ObsidianFury1/ultrasonic-landing-prediction/code/pipeline/web_assets/session_report.html

Session -- Per-throw report

No valid prediction

Landing scope · polar from centroid

Predicted landing

Raw trilateration

range r

bearing θ

x

z

Raw Bias-corrected

Ground truth · centroid + 2-sensor survey

Recommended references: centroid + -- — the two sensors nearest the predicted landing.

centroid S1 S2 S3

Accept recommended L → centroid

m

L → --

m

L → --

m

Compute & save → next

The recommendation only chooses which tapes are easiest to measure accurately; the landing is solved from the three measured distances, so accepting it does not bias the result.

Surveyed vs predicted

2-D Euclidean error · raw prediction

truth r

truth θ

truth x

truth z

Saved to session.json → ground_truth. Page is now frozen and self-contained.

Trajectory · vertical profile (downrange × height)

raw Kalman parabola fit

2D 3D

Range vs time · per-sensor gate behaviour

accepted gated throw window

Triplets used · in-window

Heading φ · speed v_h

Temp · sound m/s

Fit dof (N − 3)

Malformed lines

Small-sample caveat
