ObsidianFury1/ultrasonic-landing-prediction/optical/calib/targets/aruco_markers.pdf

DICT_4X4_50 ID 0 (100 x 100 mm)
Optical.md sect 3.3 -- floor marker.

H scale bar: measure this line, must be 100 mm V scale bar: 100 mm

DICT_4X4_50 ID 1 (100 x 100 mm)
Optical.md sect 3.3 -- floor marker.

H scale bar: measure this line, must be 100 mm V scale bar: 100 mm

DICT_4X4_50 ID 2 (100 x 100 mm)
Optical.md sect 3.3 -- floor marker.

H scale bar: measure this line, must be 100 mm V scale bar: 100 mm

DICT_4X4_50 ID 3 (100 x 100 mm)
Optical.md sect 3.3 -- floor marker.

H scale bar: measure this line, must be 100 mm V scale bar: 100 mm

DICT_4X4_50 ID 4 (100 x 100 mm)
Optical.md sect 3.3 -- floor marker.

H scale bar: measure this line, must be 100 mm V scale bar: 100 mm

DICT_4X4_50 ID 5 (100 x 100 mm)
Optical.md sect 3.3 -- floor marker.

H scale bar: measure this line, must be 100 mm V scale bar: 100 mm

DICT_4X4_50 ID 6 (100 x 100 mm)
Optical.md sect 3.3 -- floor marker.

H scale bar: measure this line, must be 100 mm V scale bar: 100 mm

DICT_4X4_50 ID 7 (100 x 100 mm)
Optical.md sect 3.3 -- floor marker.

H scale bar: measure this line, must be 100 mm V scale bar: 100 mm
