ObsidianFury1/ultrasonic-landing-prediction/optical/calib/targets/checkerboard_9x6.pdf

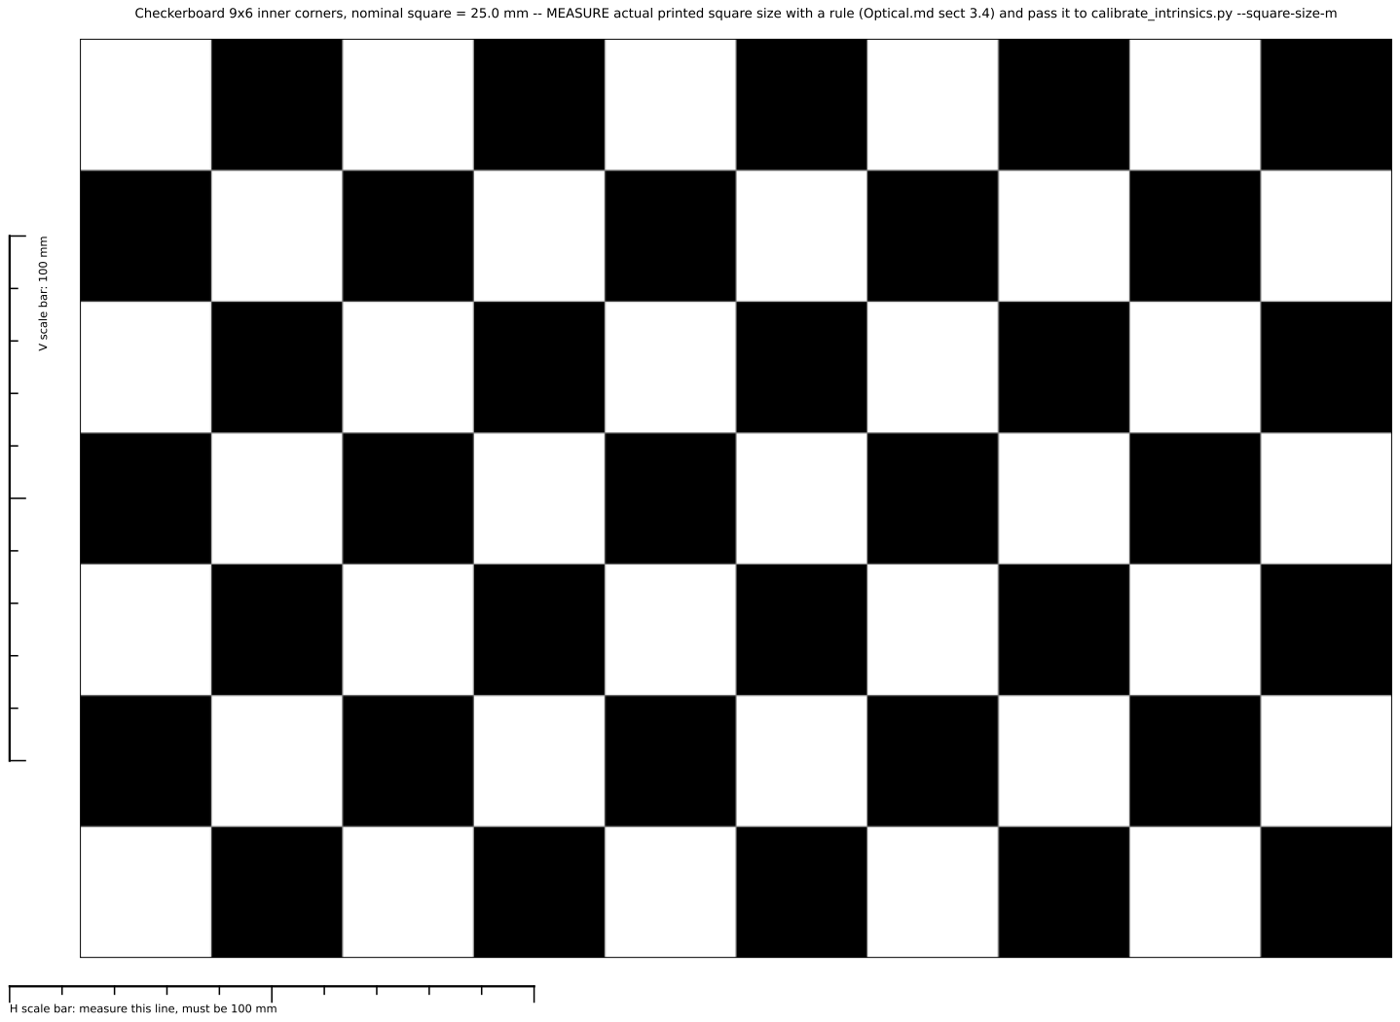
[picture p11: page 1]

Checkerboard 9x6 inner corners, nominal square = 25.0 mm -- MEASURE actual printed square size with a rule (Optical.md sect 3.4) and pass it to calibrate_intrinsics.py --square-size-m

# H scale bar: measure this line, must be 100 mm V scale bar: 100 mm
