ObsidianFury1/ultrasonic-landing-prediction/optical/trilateration_log.csv

timestamp | label | ref1_name | ref1_dist_m | ref2_name | ref2_dist_m | ref3_name | ref3_dist_m | x_m | z_m | r_m | theta_deg | ls_residual_m | cond_number | cond_warn
2026-07-11T16:20:29 | ID_2 | centroid | 0.25 | S1 | 0.7 | S2 | 0.34 | -0.0809 | 0.2345 | 0.2481 | 109.03 | 0.0021 | 1.73 | FALSE
2026-07-11T16:21:32 | ID_0 | centroid | 0.56 | S2 | 0.6 | S3 | 0.53 | -0.5563 | -0.0398 | 0.5577 | -175.91 | 0.00237 | 1.73 | FALSE
2026-07-11T16:22:06 | ID_3 | centroid | 0.52 | S1 | 0.53 | S3 | 0.58 | 0.2848 | -0.4382 | 0.5226 | -56.98 | 0.00297 | 1.73 | FALSE
2026-07-11T16:22:50 | ID_1 | centroid | 0.735 | S1 | 0.69 | S2 | 0.63 | 0.3288 | 0.6495 | 0.7279 | 63.15 | 0.00598 | 1.73 | FALSE
2026-07-11T16:24:47 | ID_4 | centroid | 1.56 | S1 | 1.68 | S3 | 1.1 | -0.0268 | -1.5651 | 1.5653 | -90.98 | 0.00382 | 1.73 | FALSE
2026-07-11T16:25:19 | ID_7 | centroid | 1.38 | S2 | 1.23 | S3 | 1.17 | -1.3778 | -0.072 | 1.3797 | -177.01 | 0.00023 | 1.73 | FALSE
2026-07-11T16:47:17 | Camera | centroid | 3 | S1 | 3.15 | S3 | 2.44 | -0.5892 | -2.9297 | 2.9884 | -101.37 | 0.00846 | 1.73 | FALSE
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
