ObsidianFury1/ultrasonic-landing-prediction/code/campaign_report/error_vs_heading.png

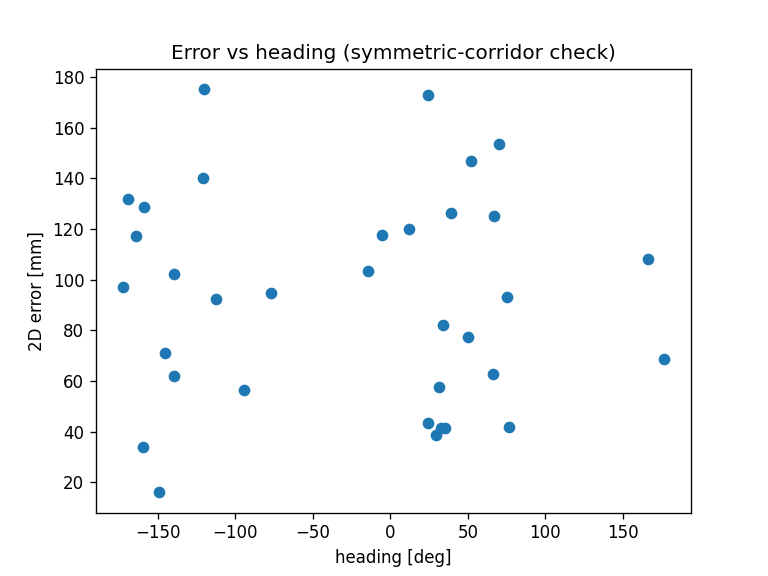
code/campaign_report/error_vs_heading.png
