ObsidianFury1/ultrasonic-landing-prediction/code/campaign_report/triplets_hist.png

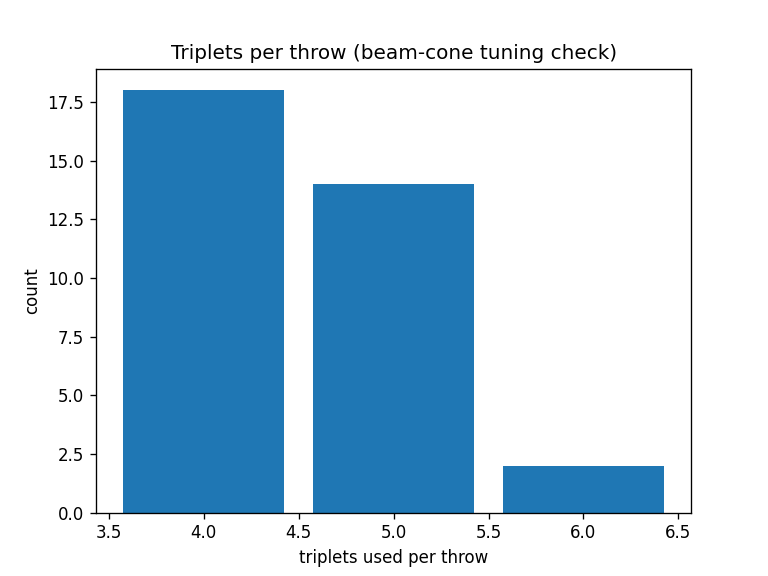
code/campaign_report/triplets_hist.png
