ObsidianFury1/ultrasonic-landing-prediction/code/data/sessions/2026-07-09_T35/plots/trajectory_fit.png

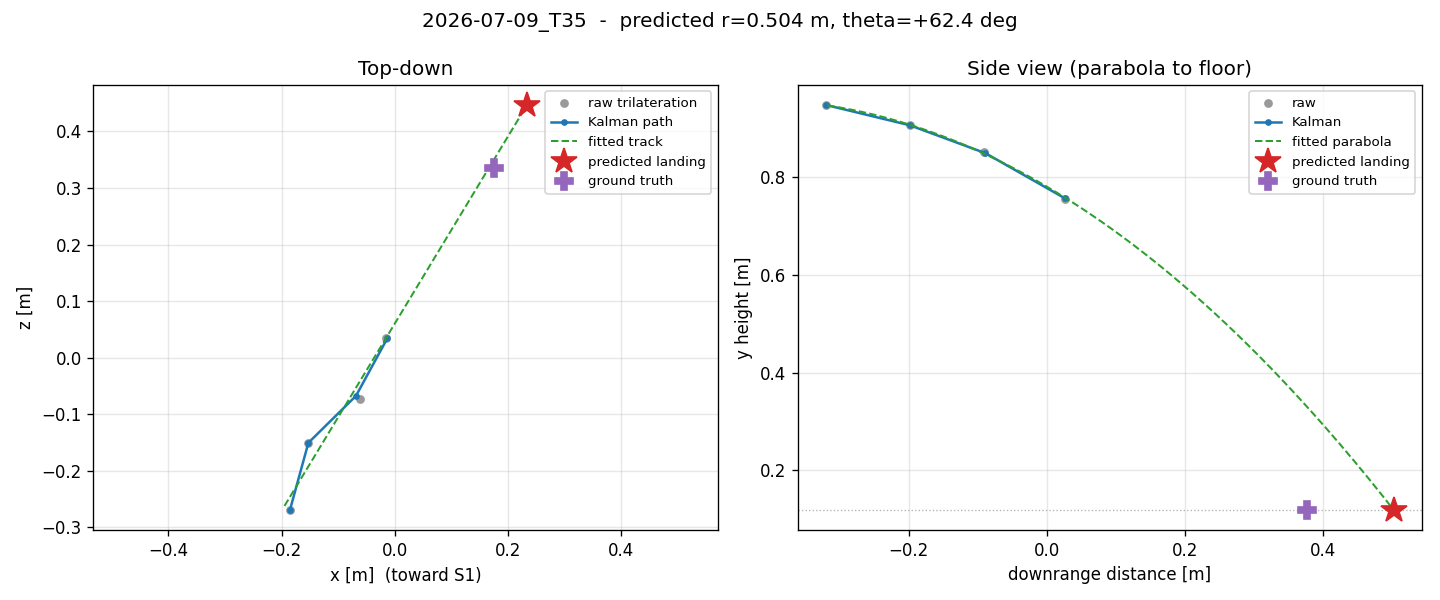
code/data/sessions/2026-07-09_T35/plots/trajectory_fit.png
