ObsidianFury1/ultrasonic-landing-prediction/code/data/sessions/2026-07-09_T54/plots/range_vs_time.png

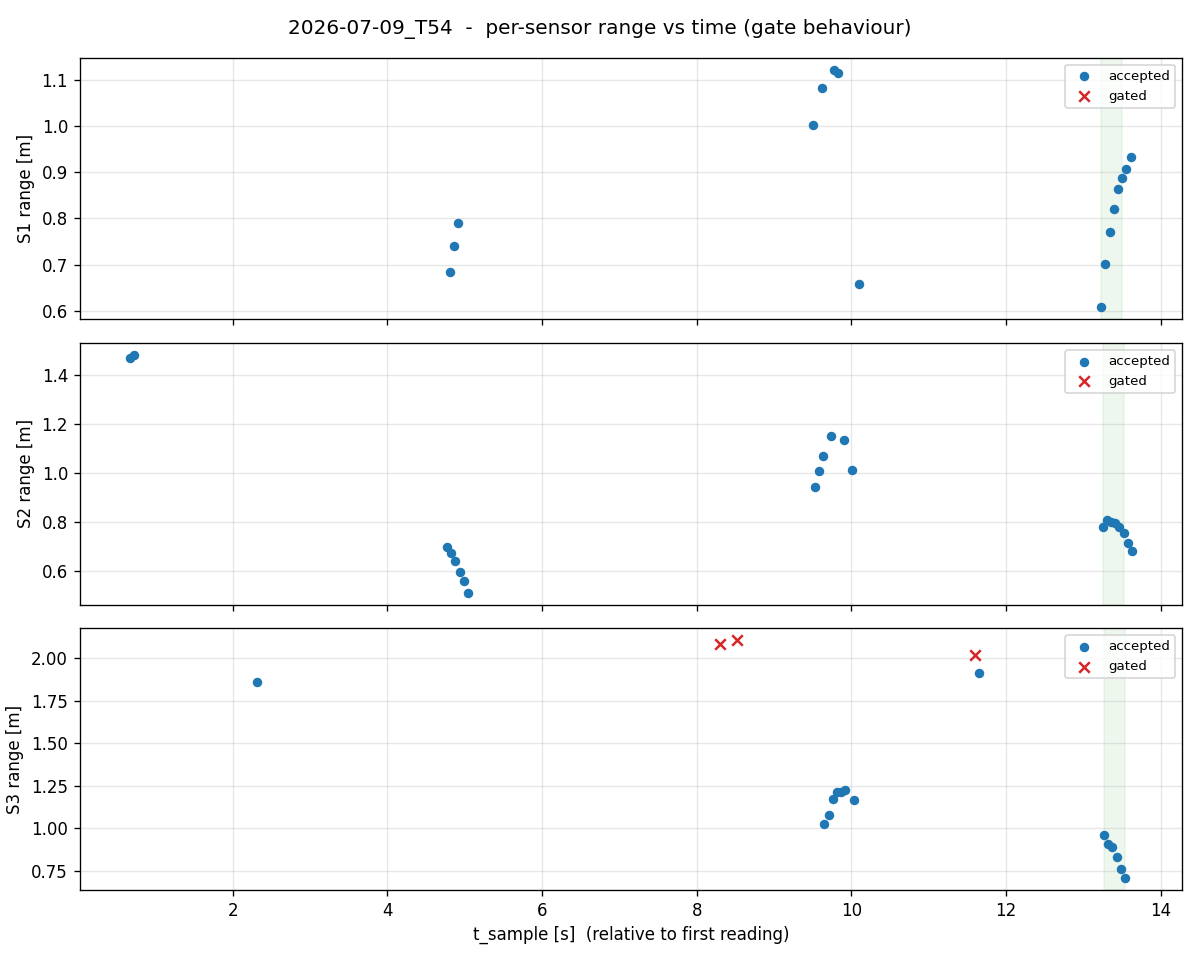
code/data/sessions/2026-07-09_T54/plots/range_vs_time.png
