ObsidianFury1/ultrasonic-landing-prediction/code/data/sessions/demo/sim_2026-07-09_010625_S06/plots/range_vs_time.png

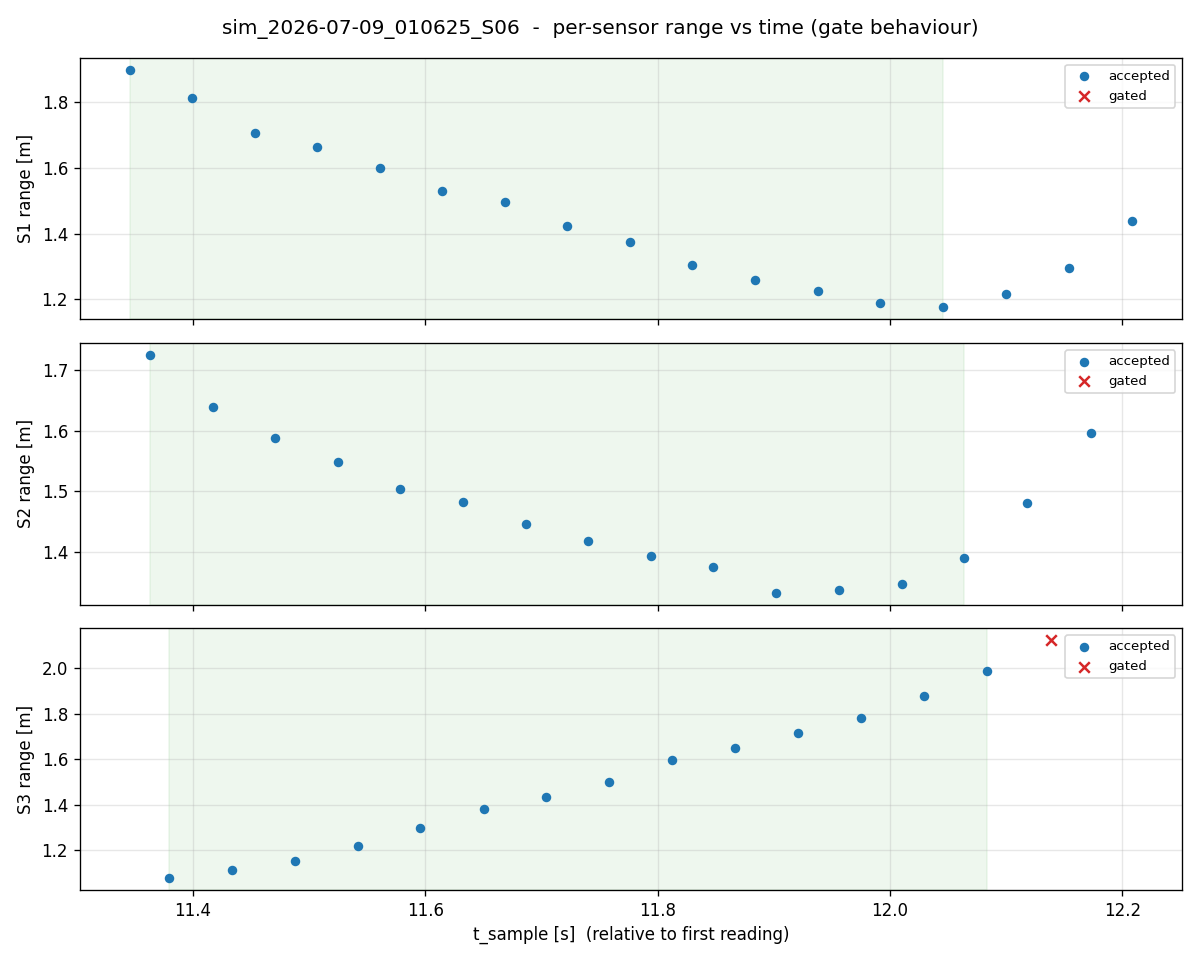
code/data/sessions/demo/sim_2026-07-09_010625_S06/plots/range_vs_time.png
