ObsidianFury1/ultrasonic-landing-prediction/code/data/sessions/demo/sim_2026-07-09_010625_S07/plots/trajectory_true.png

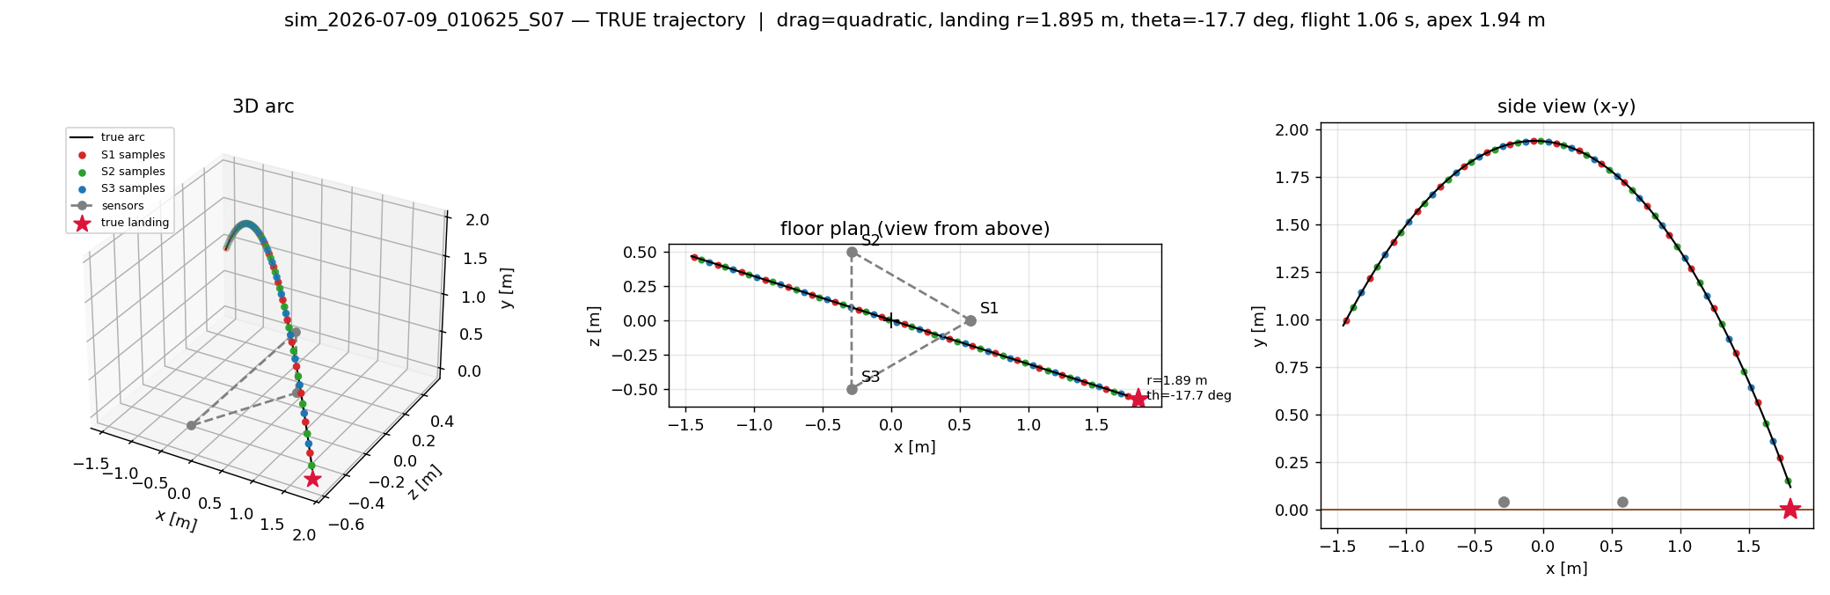
code/data/sessions/demo/sim_2026-07-09_010625_S07/plots/trajectory_true.png
