ObsidianFury1/ultrasonic-landing-prediction/code/data/sessions/demo/sim_2026-07-09_010625_S09/plots/trajectory_fit.png

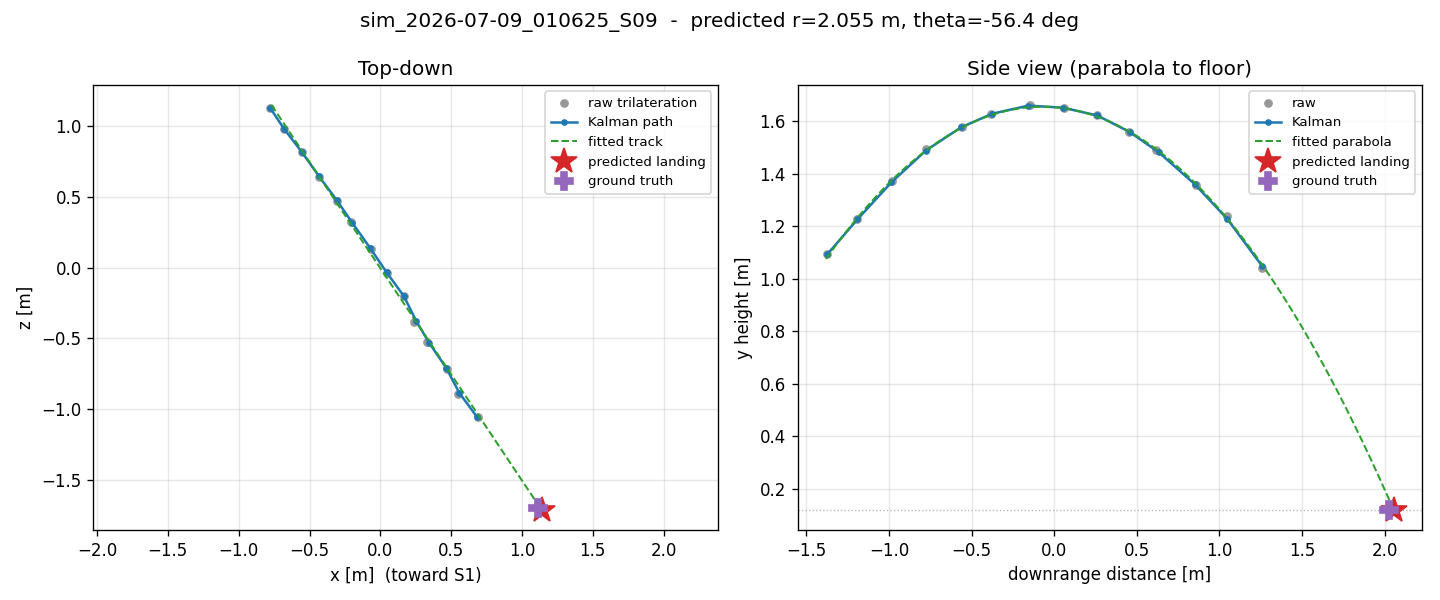
code/data/sessions/demo/sim_2026-07-09_010625_S09/plots/trajectory_fit.png
