ObsidianFury1/ultrasonic-landing-prediction/code/report/figures/array_geometry.png

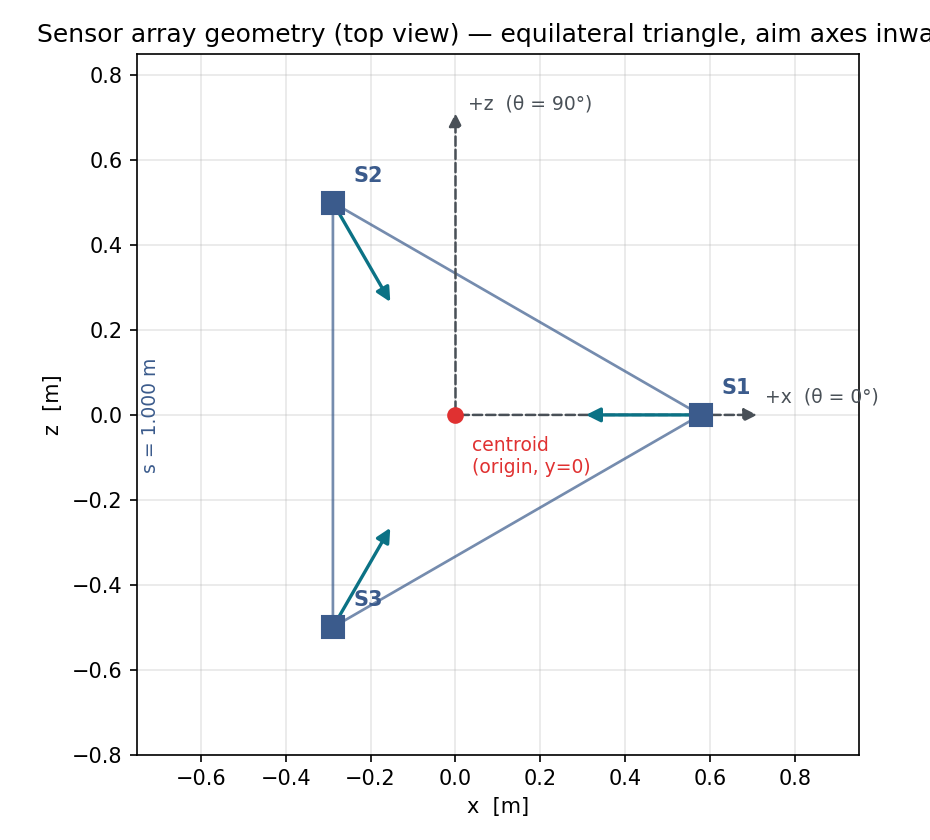
code/report/figures/array_geometry.png
