ObsidianFury1/ultrasonic-landing-prediction/docs/presentation-figures/slide03_hardware_geometry.png

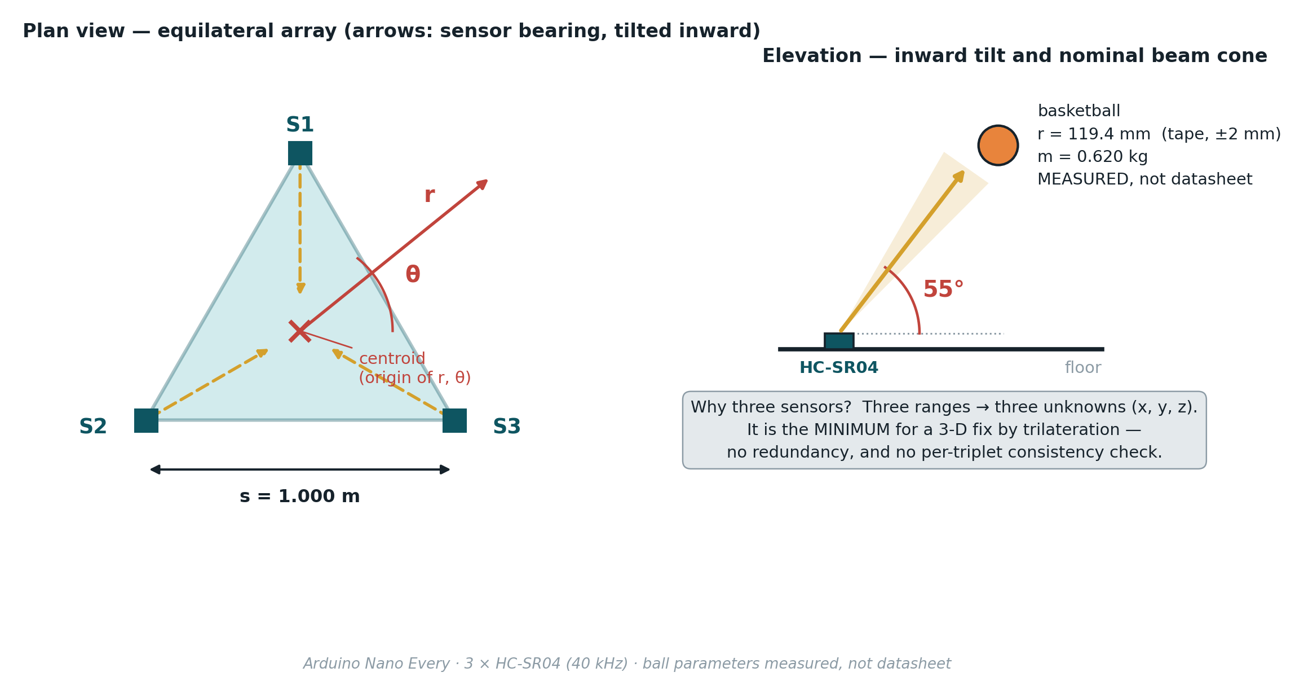
docs/presentation-figures/slide03_hardware_geometry.png
