ObsidianFury1/ultrasonic-landing-prediction/docs/presentation-figures/slide04_timing_diagram.png

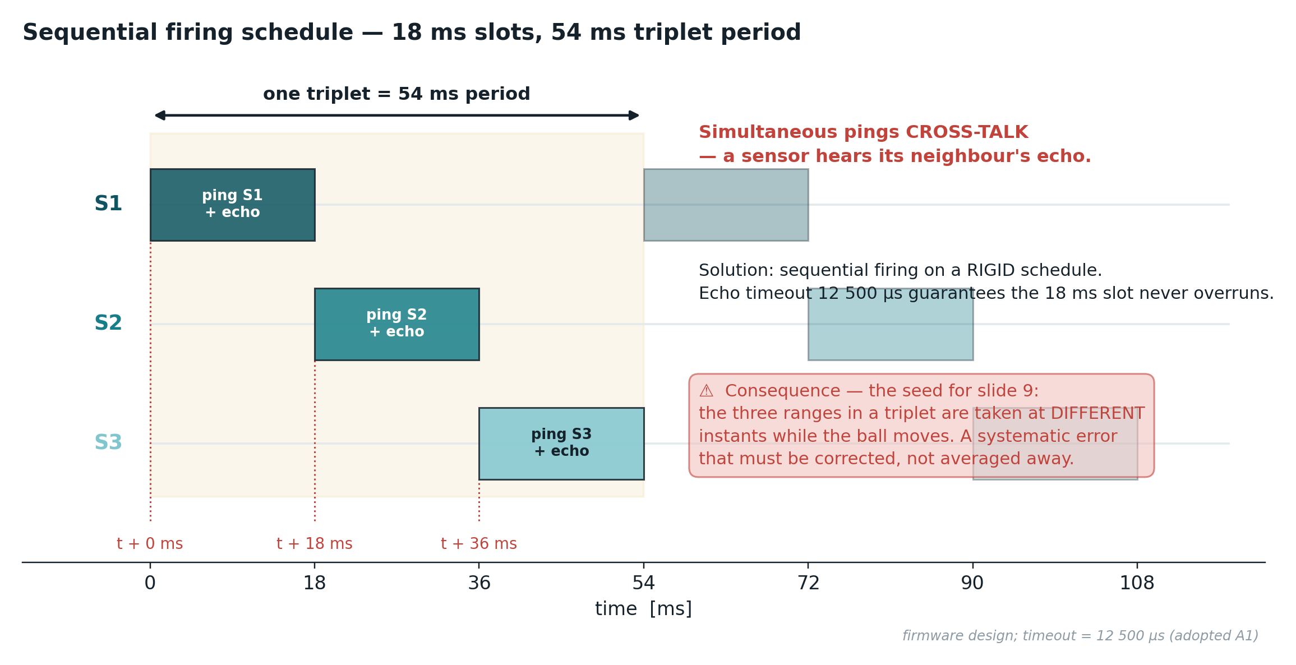
docs/presentation-figures/slide04_timing_diagram.png
