ObsidianFury1/ultrasonic-landing-prediction/docs/presentation-figures/slide07_error_budget.png

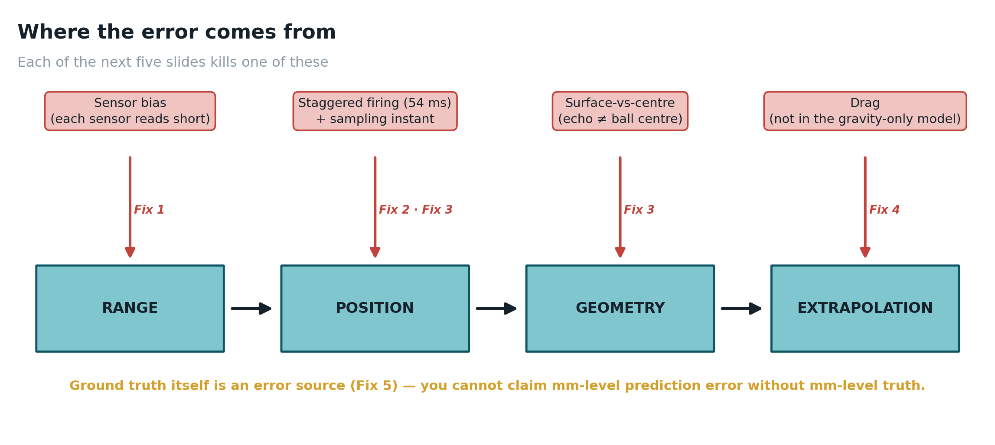
docs/presentation-figures/slide07_error_budget.png
