ObsidianFury1/ultrasonic-landing-prediction/docs/presentation-figures/slide14_campaign.png

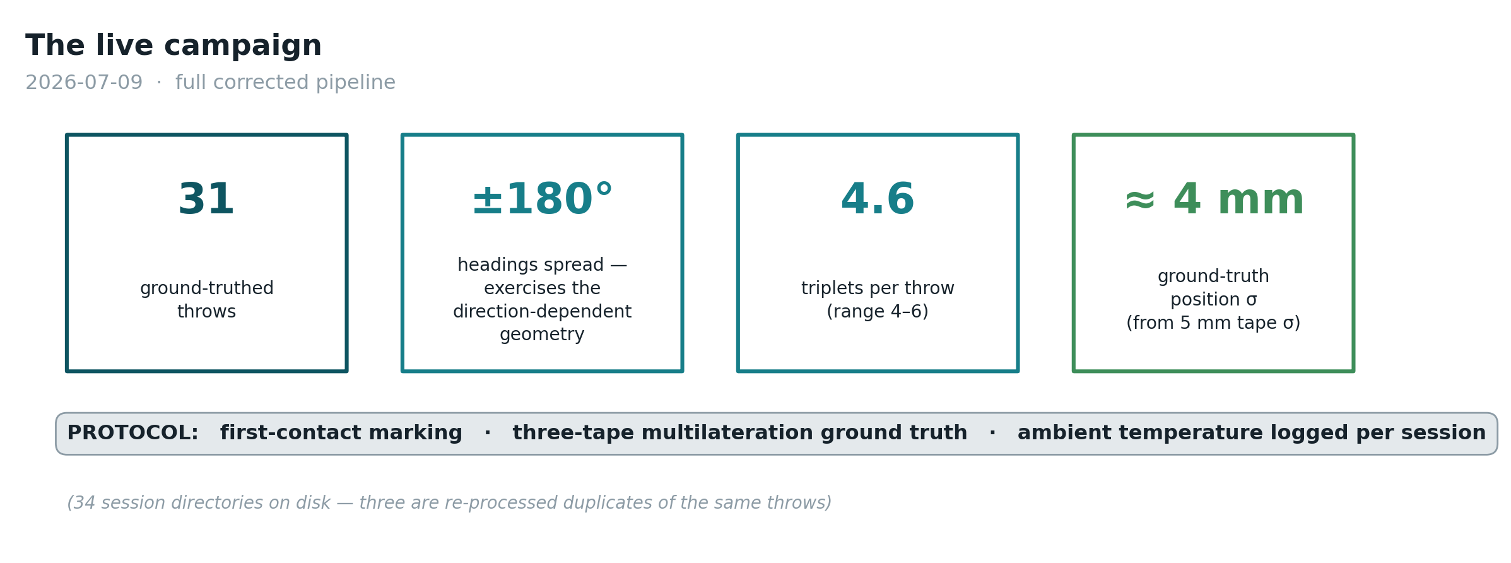
docs/presentation-figures/slide14_campaign.png
