ObsidianFury1/ultrasonic-landing-prediction/docs/presentation-figures/slide16_uncertainty_ellipse.png

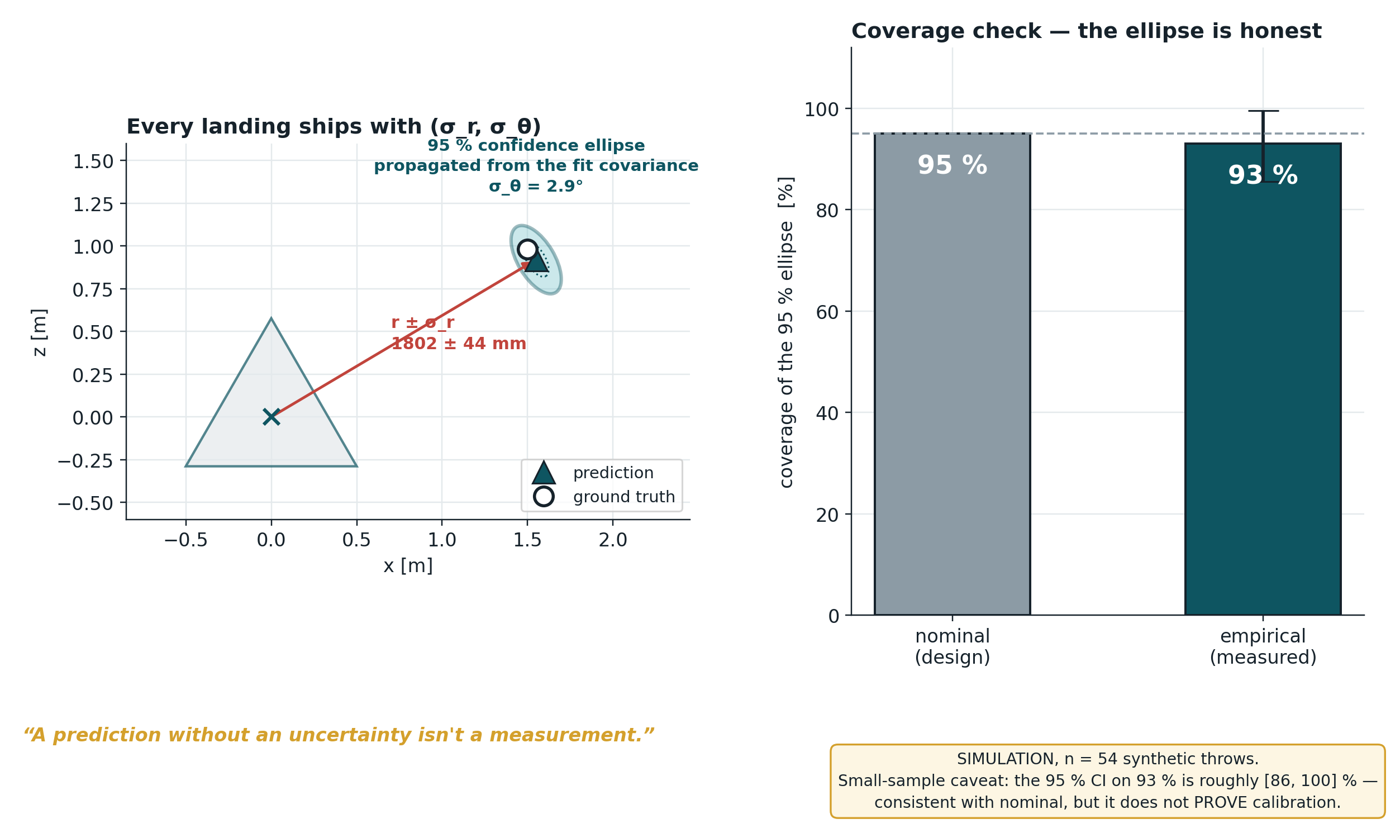
docs/presentation-figures/slide16_uncertainty_ellipse.png
