ObsidianFury1/ultrasonic-landing-prediction/docs/presentation-figures/slide17_conclusions_sensor.png

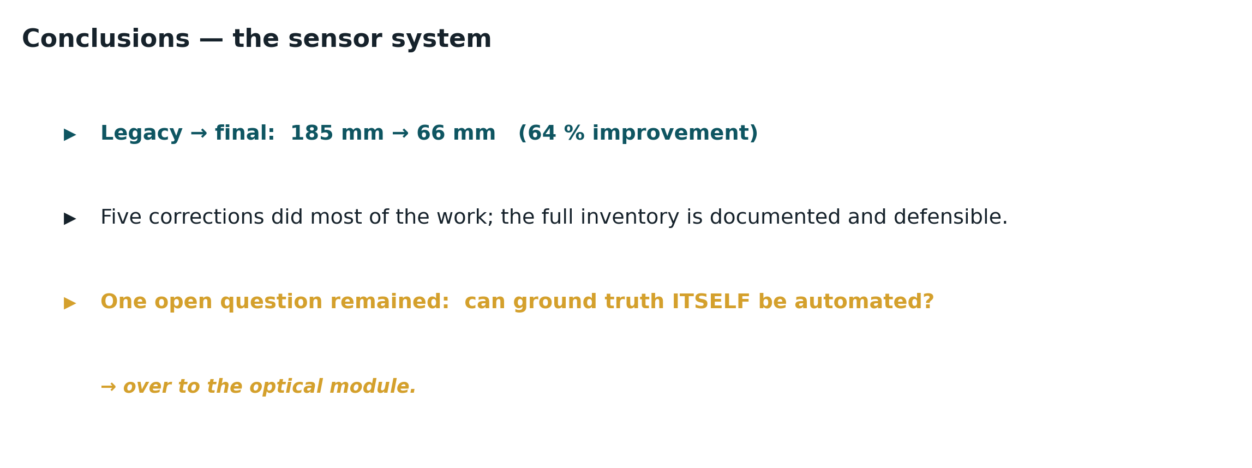
docs/presentation-figures/slide17_conclusions_sensor.png
