ObsidianFury1/ultrasonic-landing-prediction/docs/presentation-figures/slide17_waterfall_thumbnail.png

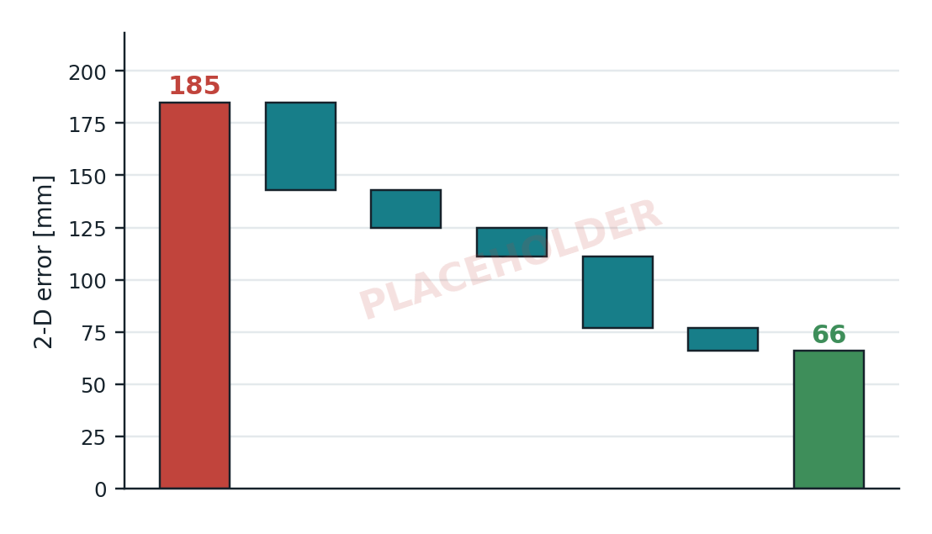
docs/presentation-figures/slide17_waterfall_thumbnail.png
