ObsidianFury1/ultrasonic-landing-prediction/docs/presentation-figures/slide19_optical_method.png

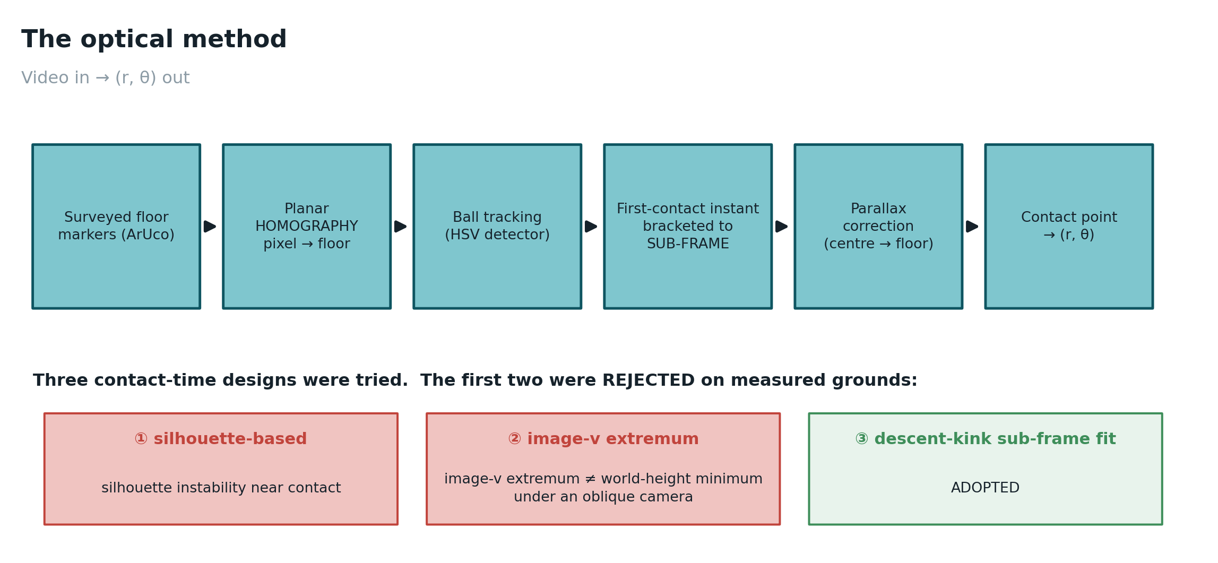
docs/presentation-figures/slide19_optical_method.png
