ObsidianFury1/ultrasonic-landing-prediction/docs/presentation-figures/slide20_pre_registered_gate.png

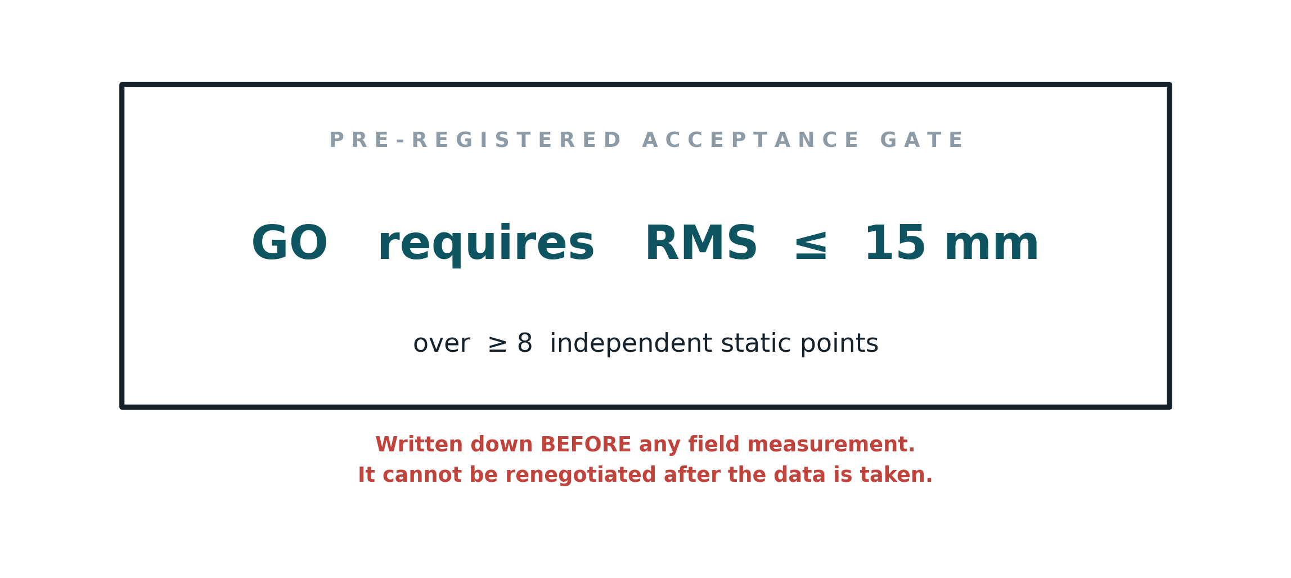
docs/presentation-figures/slide20_pre_registered_gate.png
