ObsidianFury1/ultrasonic-landing-prediction/docs/presentation-figures/slide21_optical_nogo.png

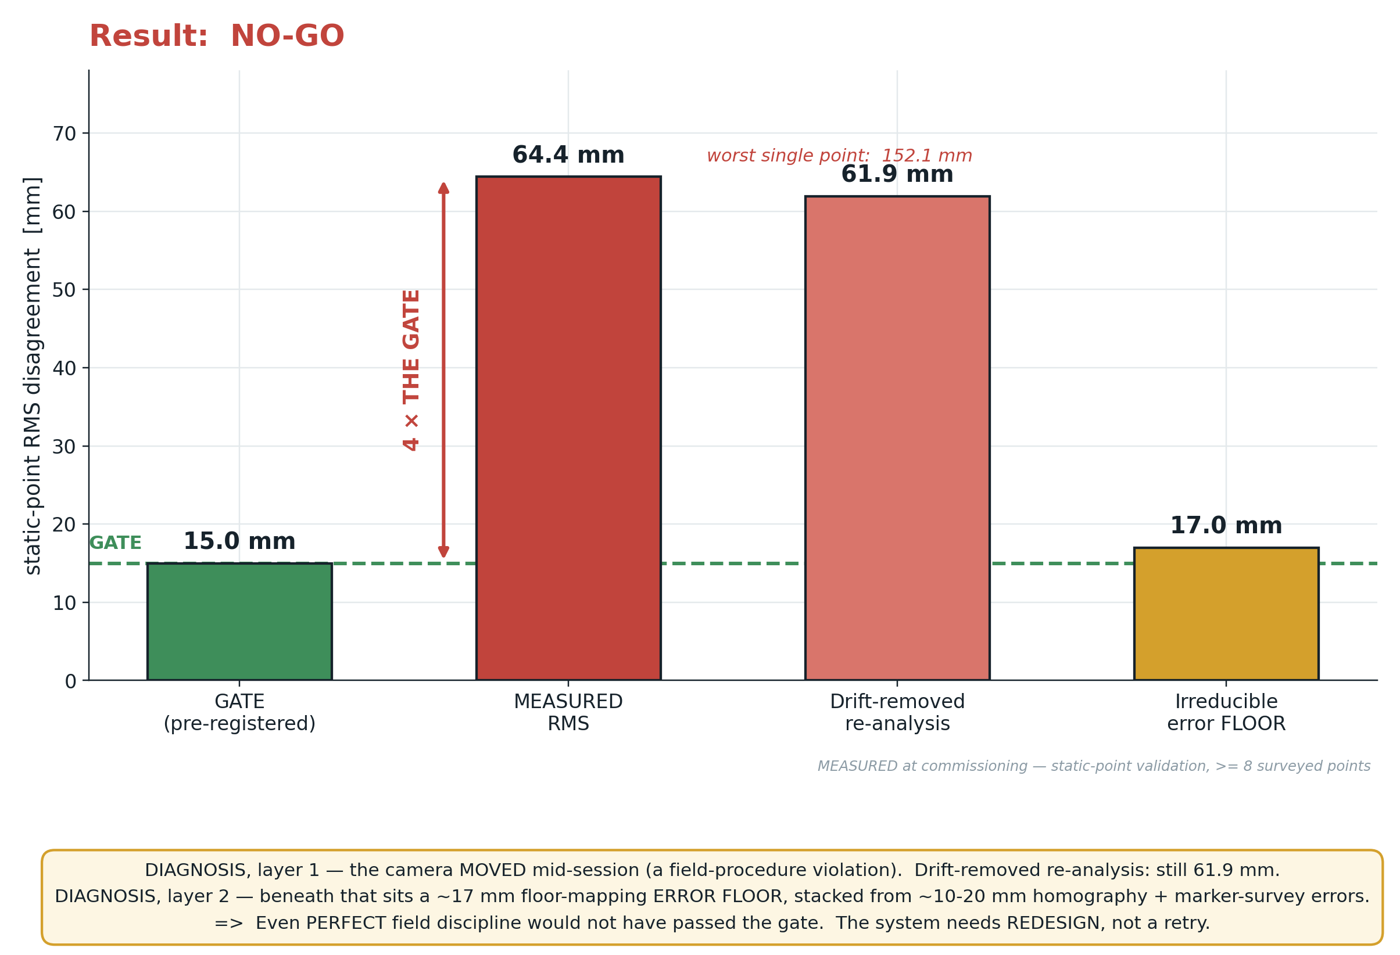
docs/presentation-figures/slide21_optical_nogo.png
