ObsidianFury1/ultrasonic-landing-prediction/docs/presentation-figures/slide22_verdict.png

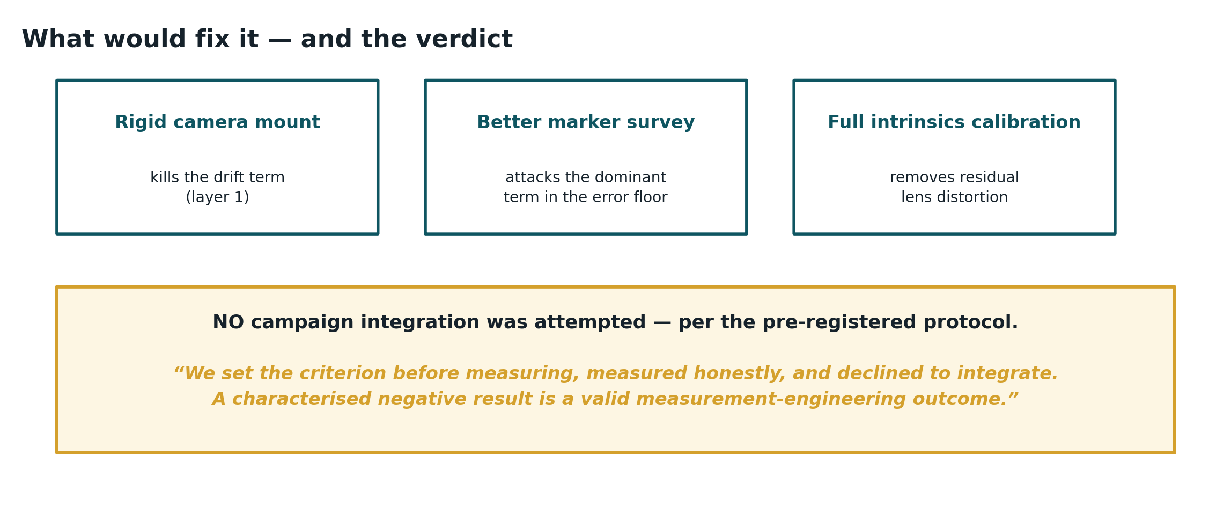
docs/presentation-figures/slide22_verdict.png
