ObsidianFury1/ultrasonic-landing-prediction/optical/calib/targets/aruco_marker_0.jpg

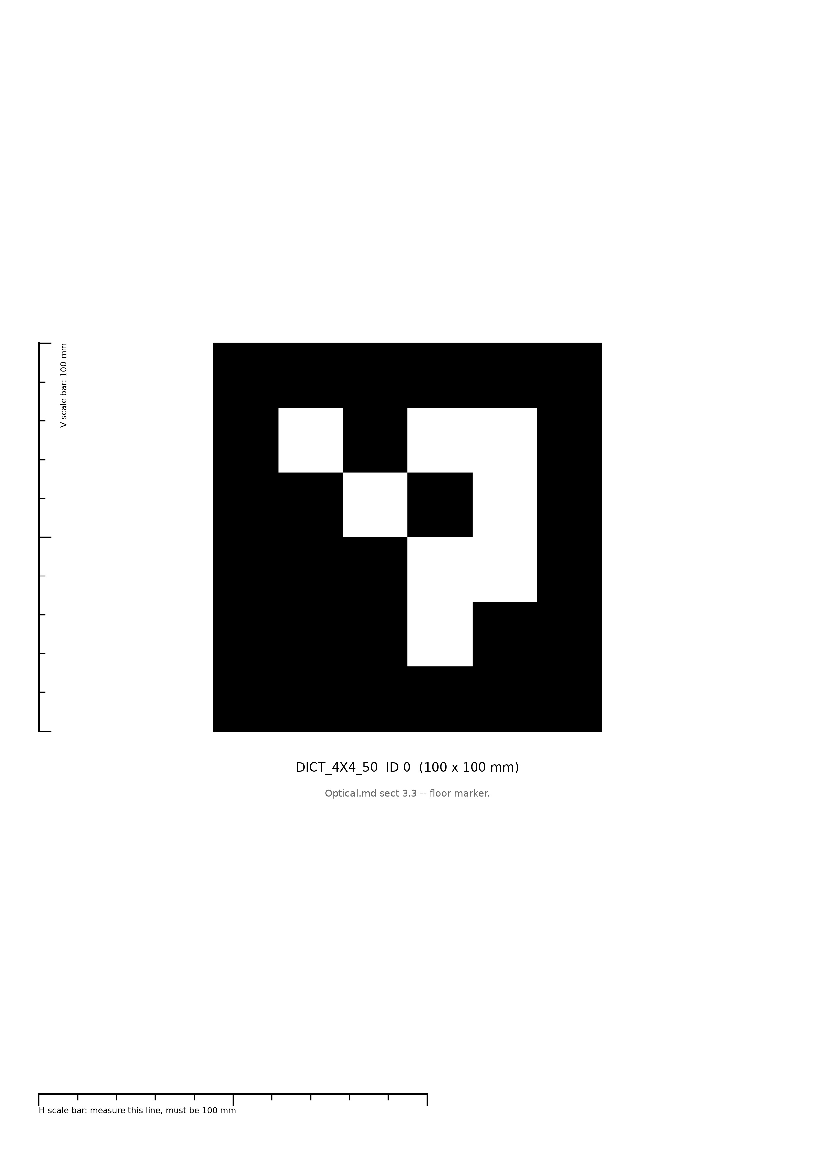
optical/calib/targets/aruco_marker_0.jpg
