ObsidianFury1/ultrasonic-landing-prediction/optical/calib/targets/aruco_marker_6.jpg

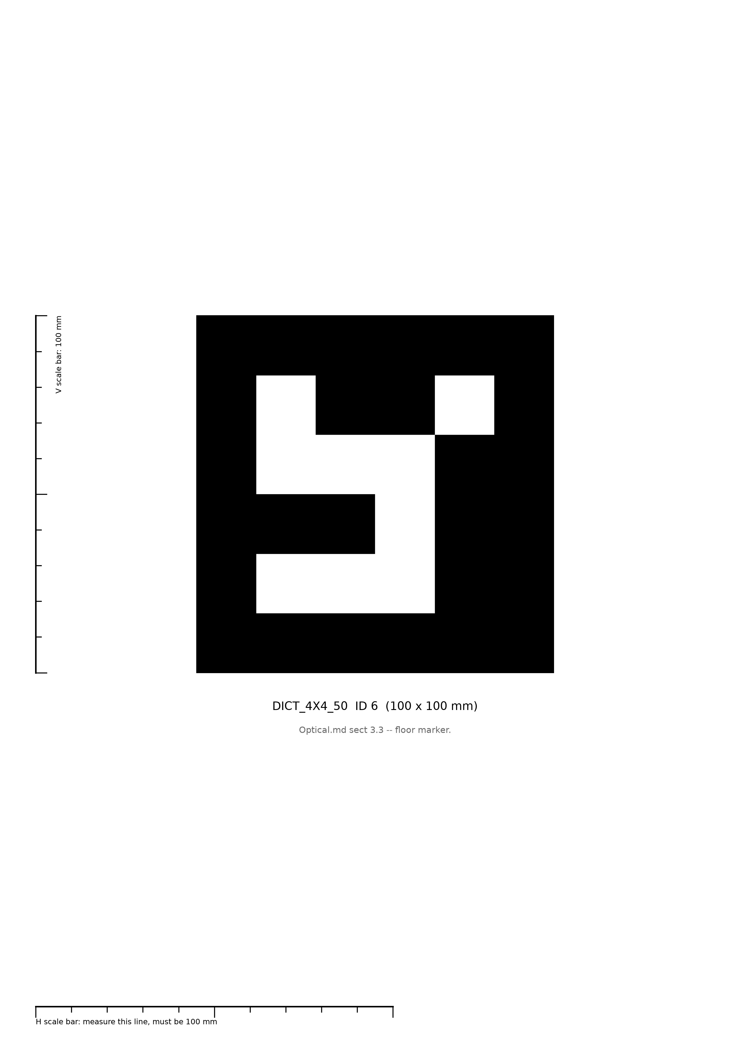
optical/calib/targets/aruco_marker_6.jpg
