ObsidianFury1/ultrasonic-landing-prediction/optical/calib/targets/checkerboard_9x6.jpg

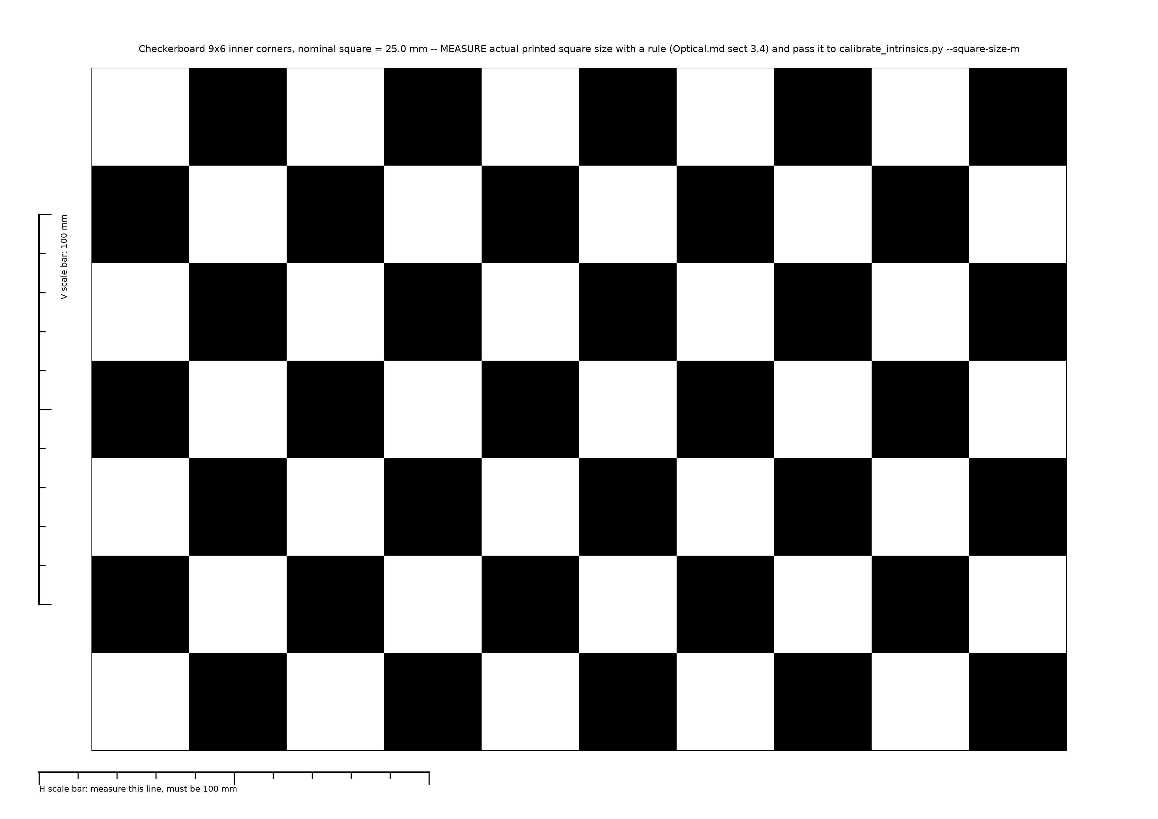
optical/calib/targets/checkerboard_9x6.jpg
