ObsidianFury1/ultrasonic-landing-prediction/docs/presentation-figures/slide13_correction_inventory.png

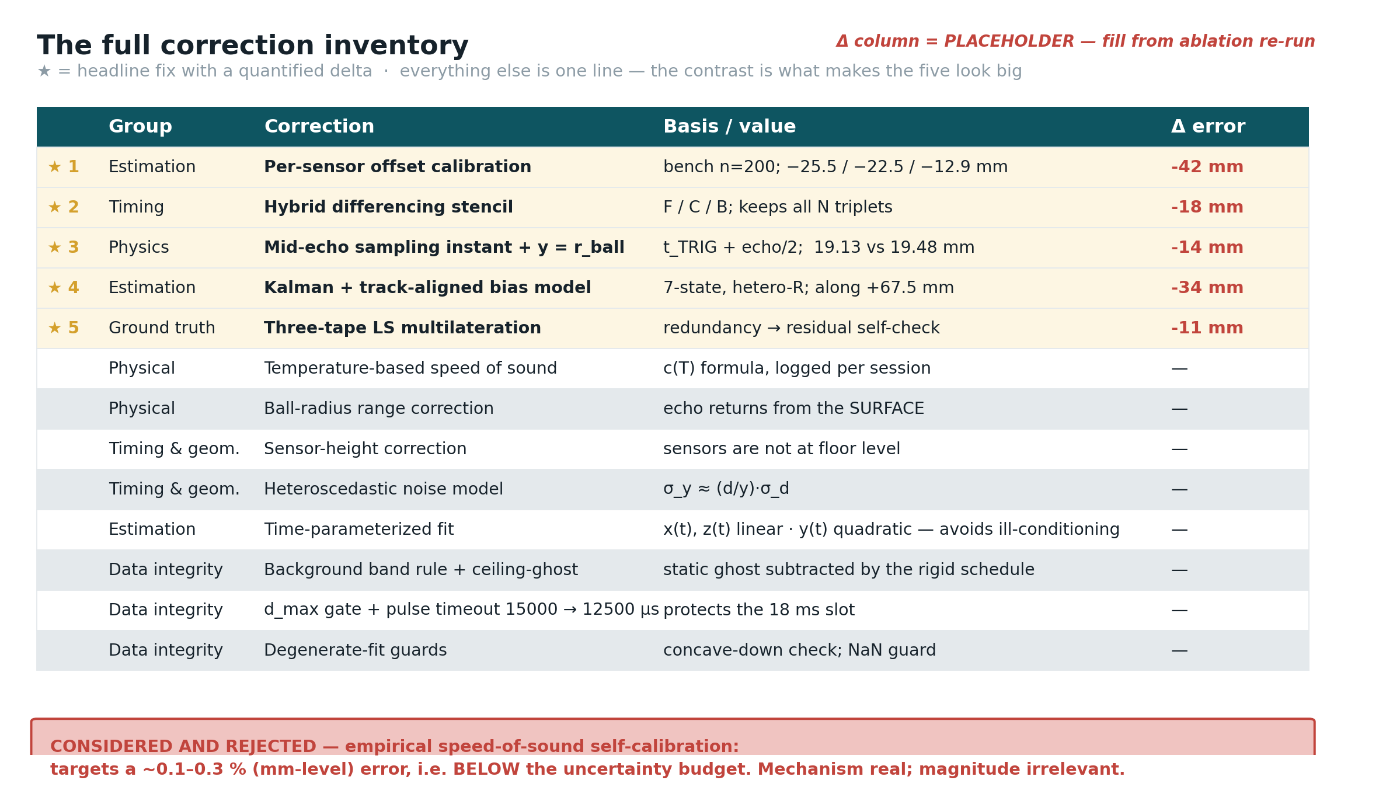
docs/presentation-figures/slide13_correction_inventory.png
