ObsidianFury1/ultrasonic-landing-prediction/optical/calib/manual_clicks_2026-07-11.png

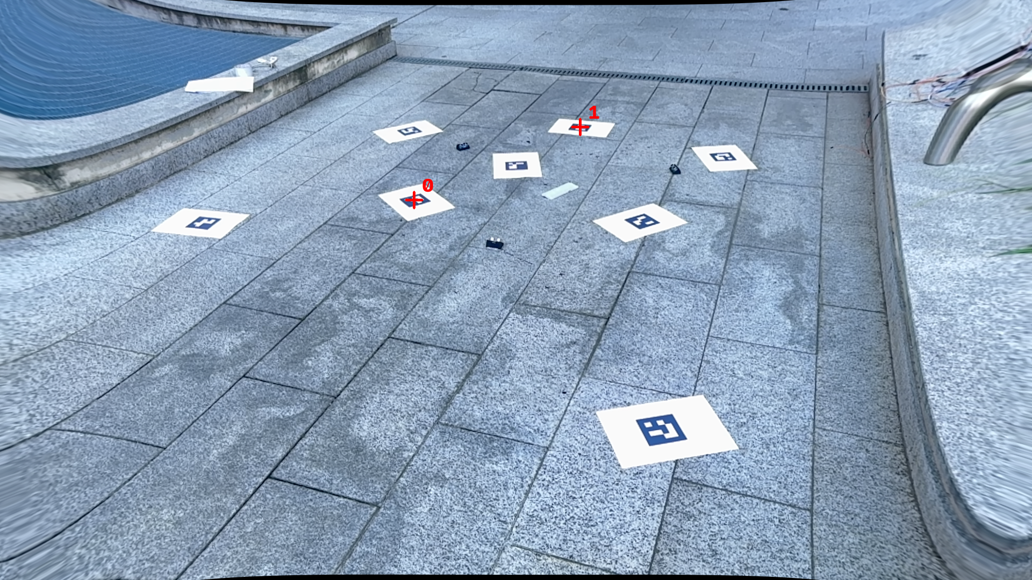
optical/calib/manual_clicks_2026-07-11.png
