ObsidianFury1/ultrasonic-landing-prediction/docs/presentation-figures/slide02_measurement_chain.png

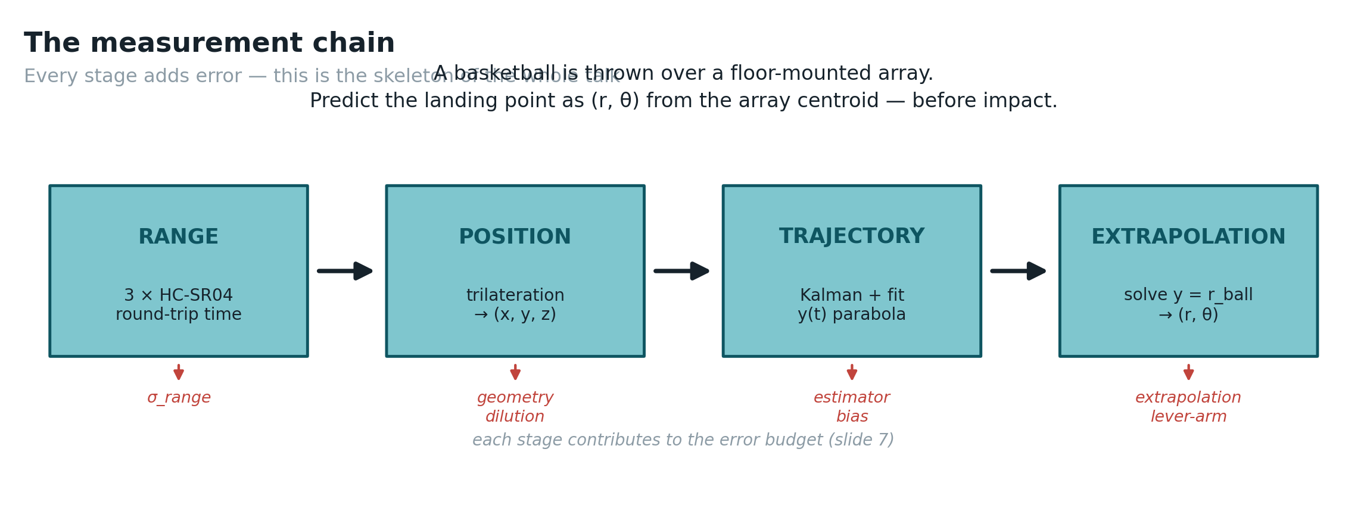
docs/presentation-figures/slide02_measurement_chain.png
