ObsidianFury1/ultrasonic-landing-prediction/docs/presentation-figures/slide15_waterfall_RESULTS.png

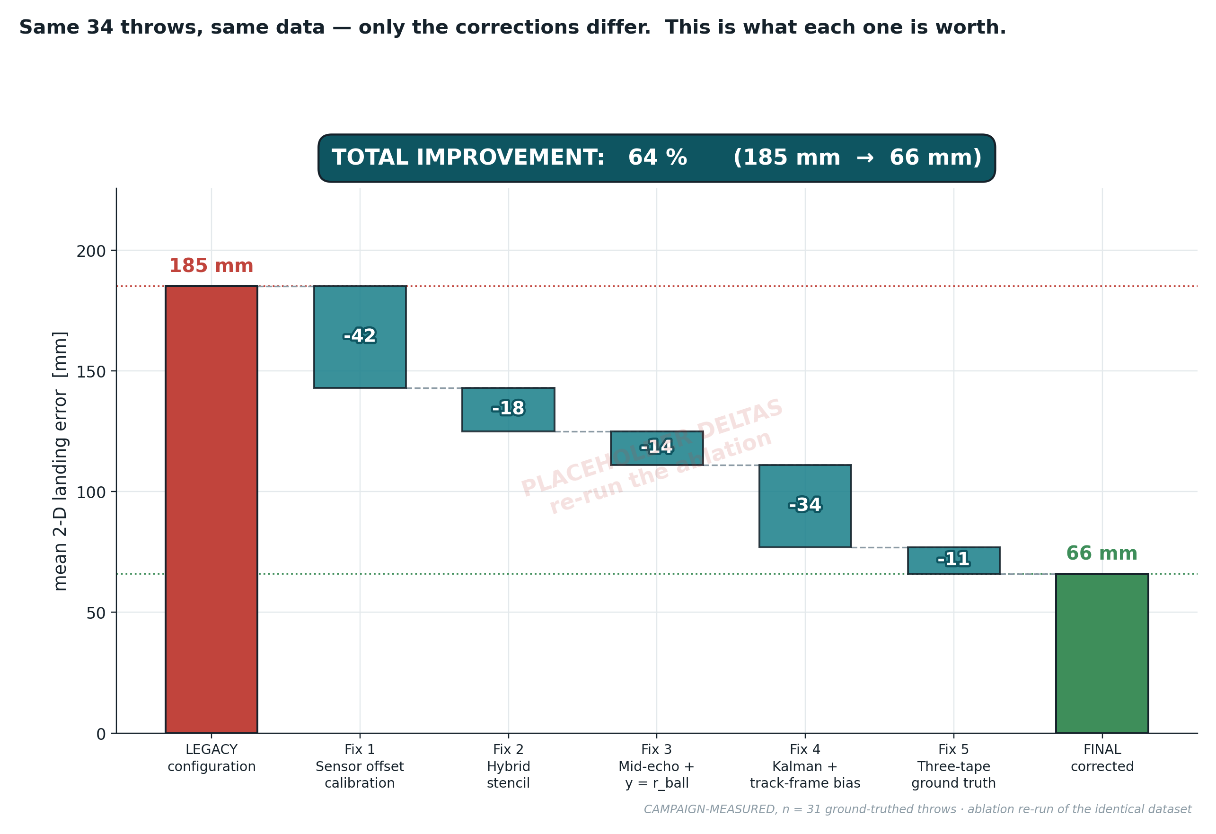
docs/presentation-figures/slide15_waterfall_RESULTS.png
