ObsidianFury1/ultrasonic-landing-prediction/code/CHANGES.md

# CHANGES.md — work order staging file

**No active work order.**

The D6 work order (tennis ball → basketball target substitution) that previously lived in this
file is **CLOSED**. Its full record now lives in `CLAUDE.md`'s own changelog (the "v2.5 → v2.6
(D6)" and "v2.6 → v2.7" sections) and in `IMPLEMENTATION_NOTES.md` Parts 15–17. See `handoff.md`
for the current project state.

The only intentionally open item project-wide is the **O-series optical amendment**
(`CLAUDE_OPTICAL.md`), tracked directly in `CLAUDE.md`'s v2.6 → v2.7 changelog — required before
Phase 5 fieldwork, out of scope for this ultrasonic module.

---

Paste the next work order here when one exists. `IMPLEMENTATION_NOTES.md` Part 15 (D6) is a
worked example of the stage-gated format this project uses: numbered stages, explicit pass
criteria, a STOP-and-confirm gate between each stage, and a close-out step that folds the result
back into `CLAUDE.md` and empties this file again.
