ObsidianFury1/ultrasonic-landing-prediction/docs/presentation-figures/slide08_fix1_sensor_offsets.png

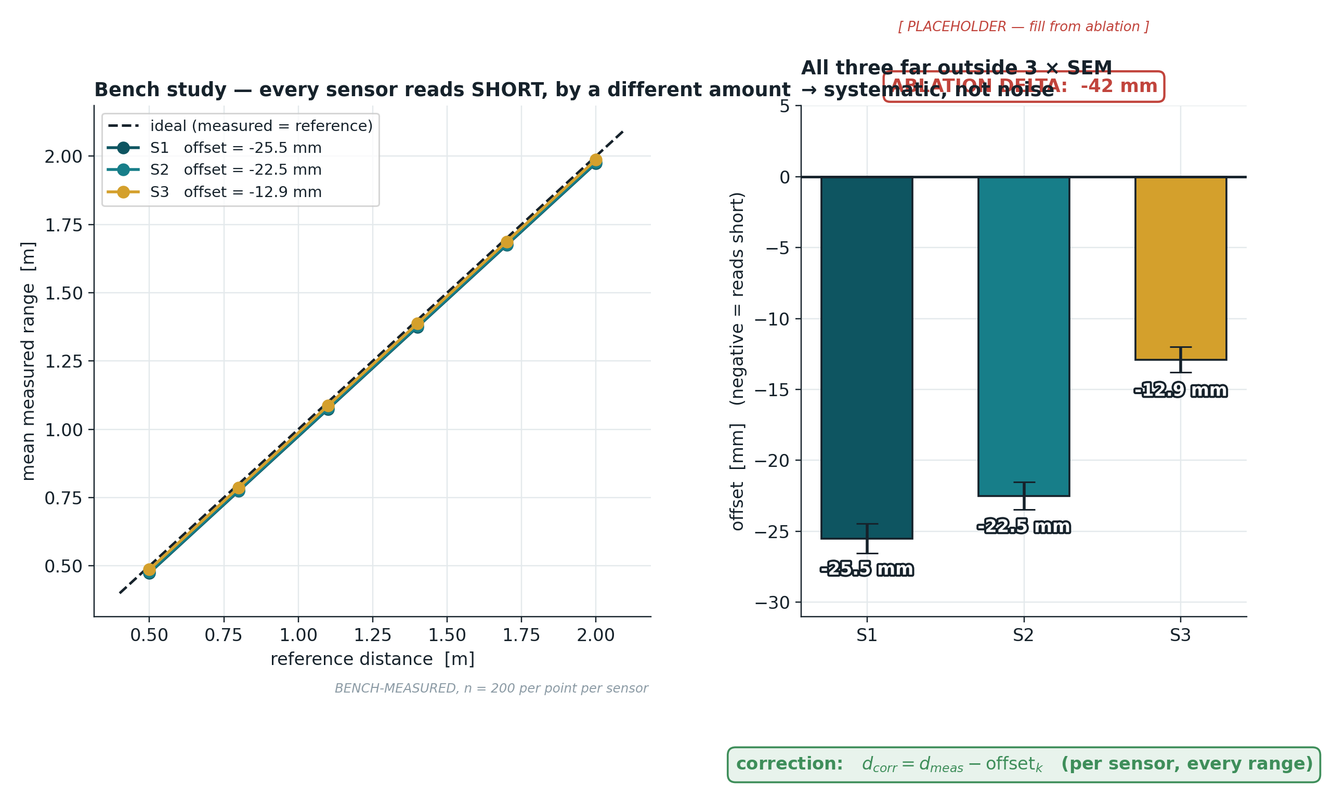
docs/presentation-figures/slide08_fix1_sensor_offsets.png
