ObsidianFury1/ultrasonic-landing-prediction/docs/presentation-figures/slide09_fix2_hybrid_stencil.png

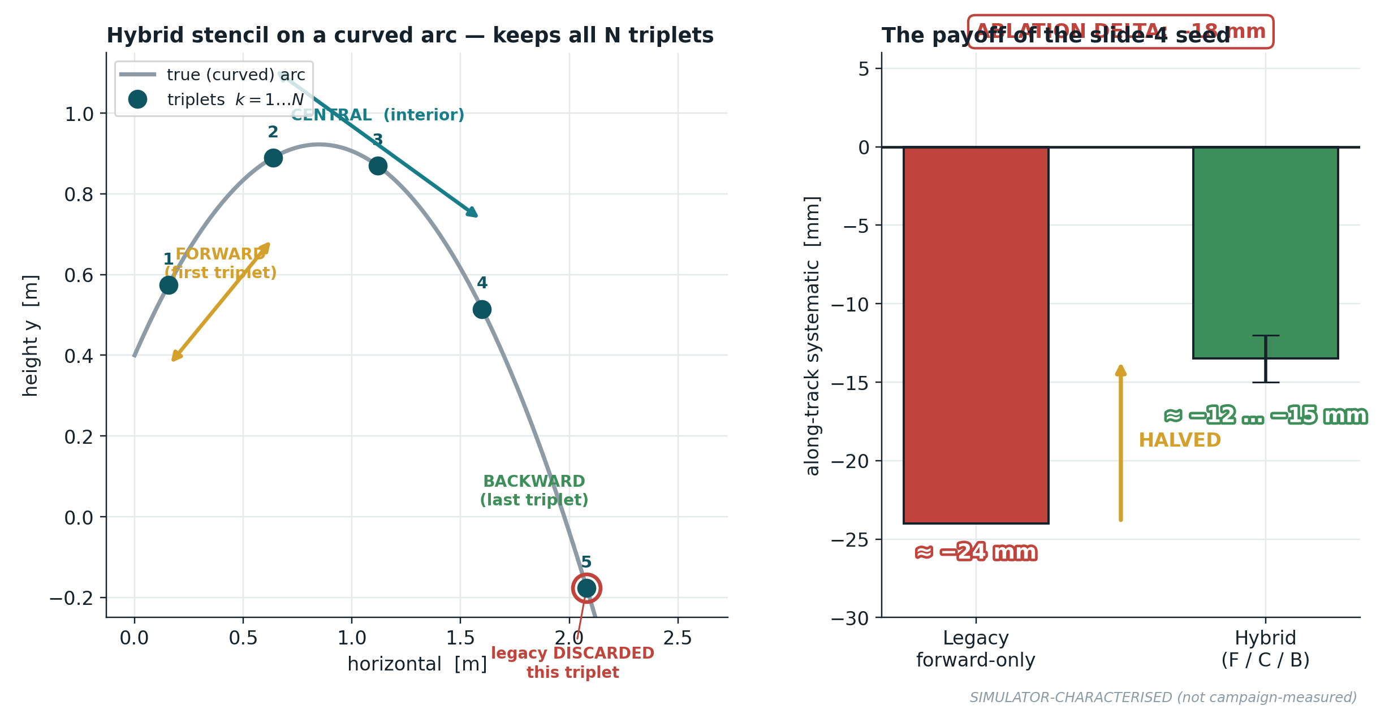
docs/presentation-figures/slide09_fix2_hybrid_stencil.png
