ObsidianFury1/ultrasonic-landing-prediction/docs/presentation-figures/slide10_fix3_instant_and_contact.png

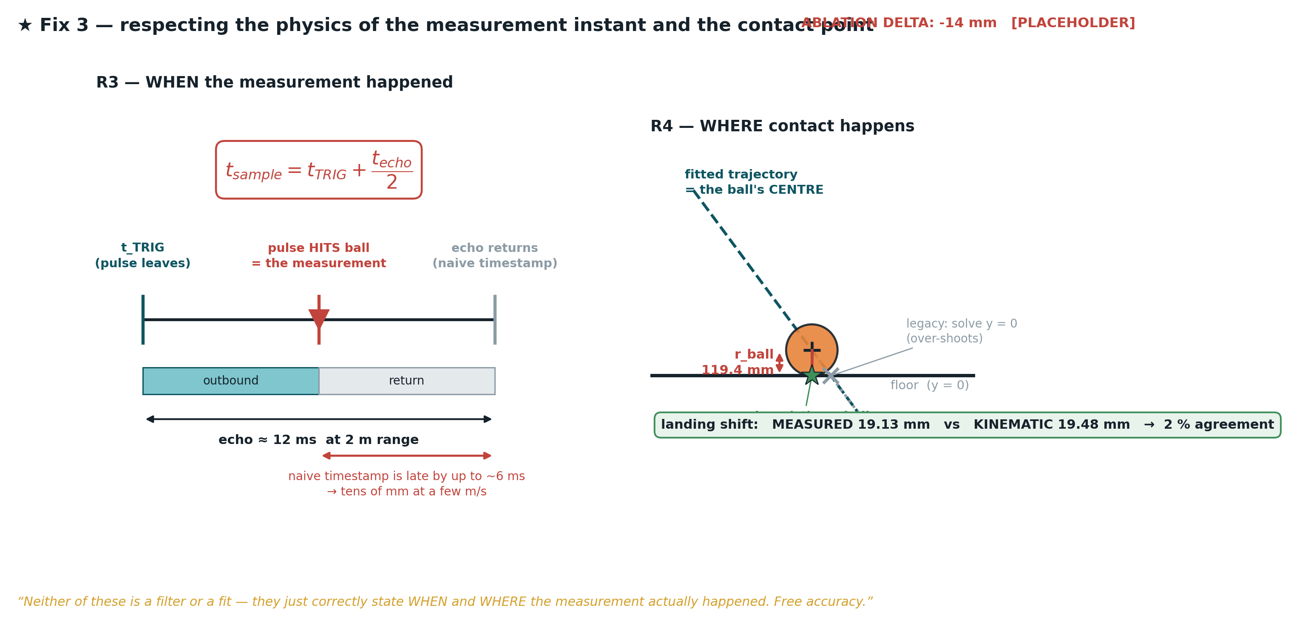
docs/presentation-figures/slide10_fix3_instant_and_contact.png
