ObsidianFury1/ultrasonic-landing-prediction/docs/presentation-figures/slide11_fix4_kalman_bias.png

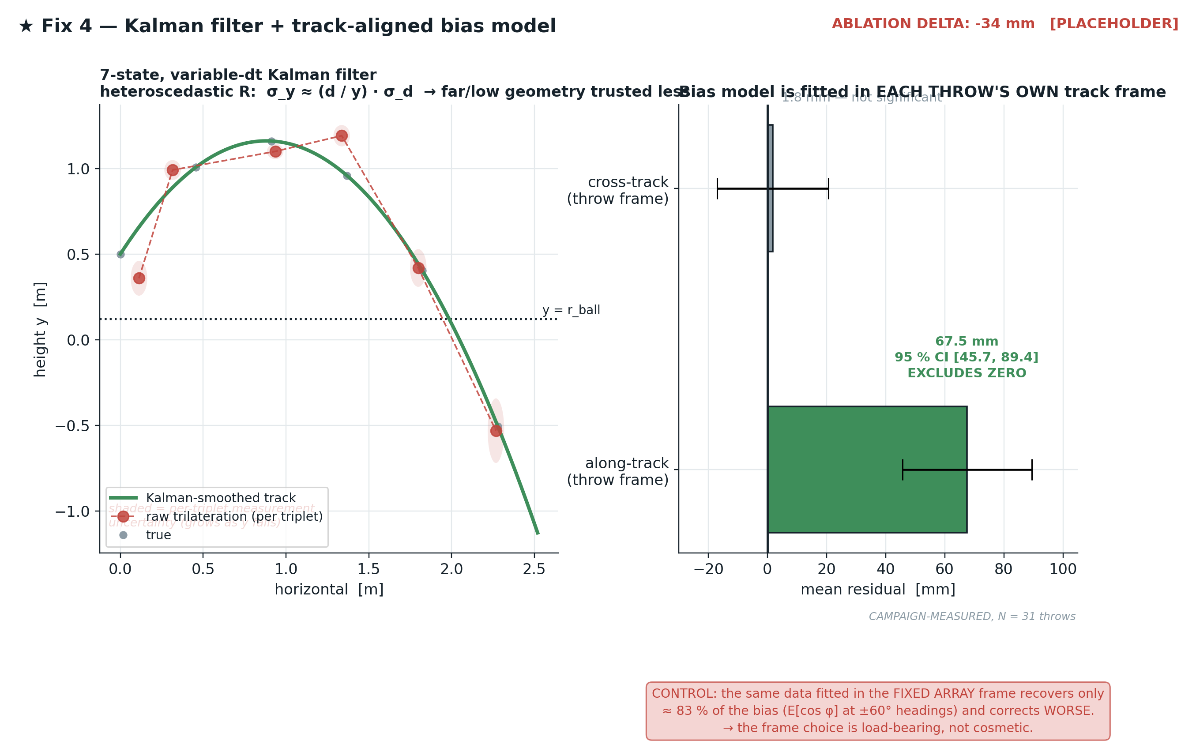
docs/presentation-figures/slide11_fix4_kalman_bias.png
