ObsidianFury1/ultrasonic-landing-prediction/docs/presentation-figures/slide12_fix5_ground_truth.png

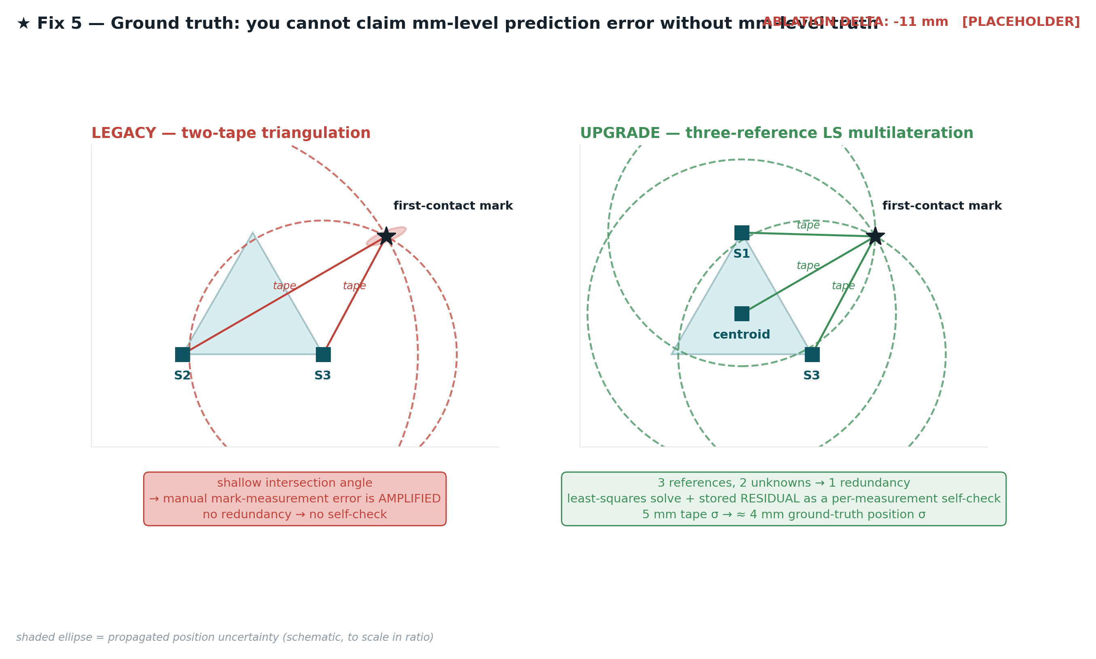
docs/presentation-figures/slide12_fix5_ground_truth.png
